sq9nje/step_attenuator/README.md

# Weinschel Step Attenuator Controller

## Links
- [WT32-ETH01](https://github.com/egnor/wt32-eth01)
