sq9nje/step_attenuator/step_attenuator.kicad_pcb

## KiCad design step_attenuator.kicad_pcb (2025-05-12)

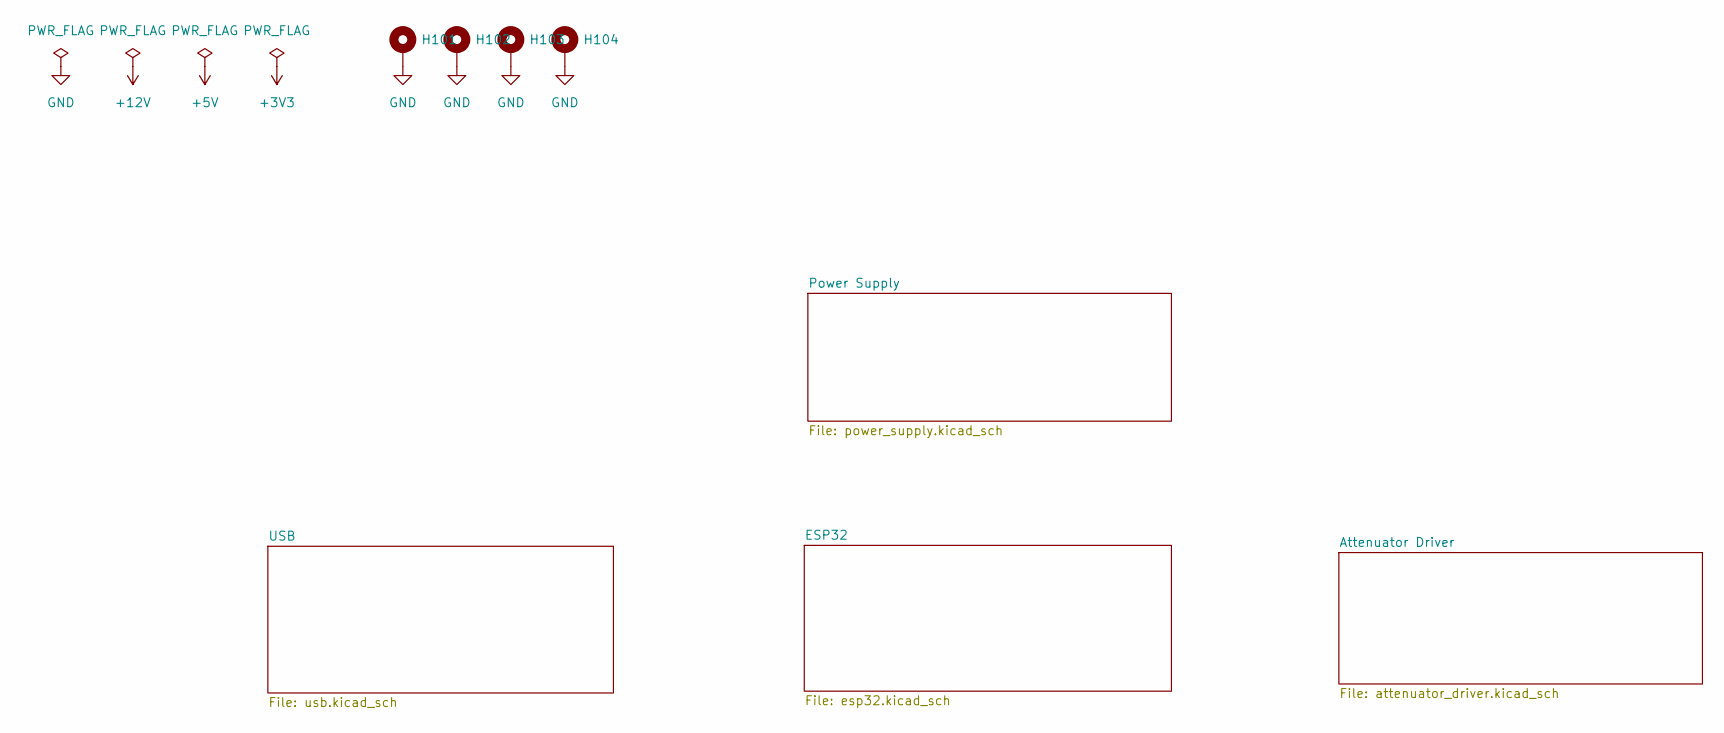
[picture p1: schematic step_attenuator.kicad_sch, Weinschel Step Attenuator Controller]

Parts:
H101, H102, H103, H104: MountingHole_Pad; MountingHole_3.2mm_M3_Pad_Via

Connections:
GND: H101.1, H102.1, H103.1, H104.1; also elsewhere on the board

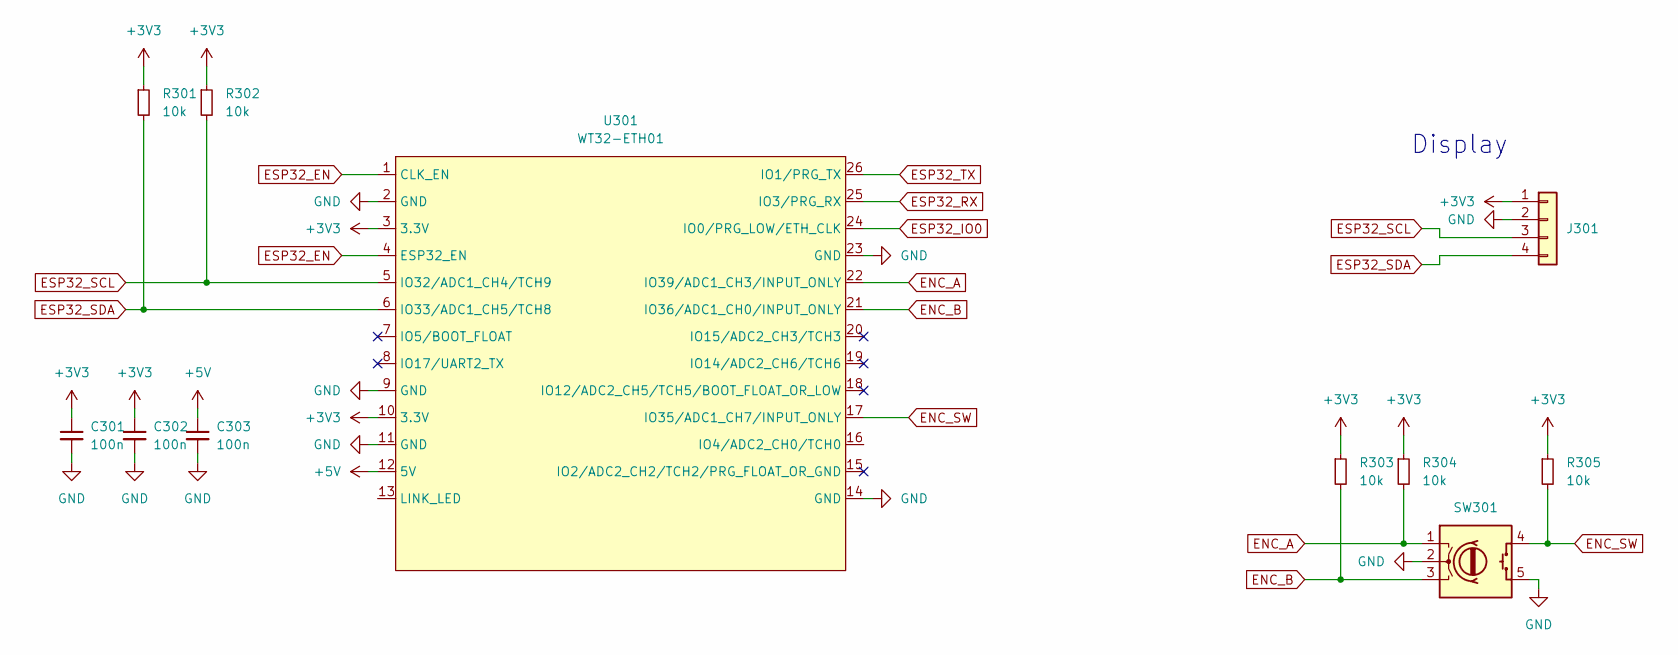
[picture p2: schematic esp32.kicad_sch, Weinschel Step Attenuator Controller]

Parts:
C301, C302, C303: 100n; C_0603_1608Metric_Pad1.08x0.95mm_HandSolder
J301: Conn_01x04; JST_XH_B4B-XH-A_1x04_P2.50mm_Vertical
R301, R302, R303, R304, R305: 10k; R_0603_1608Metric_Pad0.98x0.95mm_HandSolder
SW301: RotaryEncoder_Switch; JST_XH_B5B-XH-A_1x05_P2.50mm_Vertical
U301: WT32-ETH01

Connections:
+3V3: C301.1, C302.1, J301.1, R301.1, R302.1, R303.1, R304.1, R305.1, U301.3 (3.3V), U301.10 (3.3V); also elsewhere on the board
+5V: C303.1, U301.12 (5V); also elsewhere on the board
ENC_A: R304.2, SW301.1 (A), U301.22 (IO39/ADC1_CH3/INPUT_ONLY)
ENC_B: R303.2, SW301.3 (B), U301.21 (IO36/ADC1_CH0/INPUT_ONLY)
ENC_SW: R305.2, SW301.4 (S1), U301.17 (IO35/ADC1_CH7/INPUT_ONLY)
ESP32_EN: U301.1 (CLK_EN), U301.4 (ESP32_EN); also elsewhere on the board
ESP32_IO0: U301.24 (IO0/PRG_LOW/ETH_CLK); also elsewhere on the board
ESP32_RX: U301.25 (IO3/PRG_RX); also elsewhere on the board
ESP32_SCL: J301.3, R302.2, U301.5 (IO32/ADC1_CH4/TCH9); also elsewhere on the board
ESP32_SDA: J301.4, R301.2, U301.6 (IO33/ADC1_CH5/TCH8); also elsewhere on the board
ESP32_TX: U301.26 (IO1/PRG_TX); also elsewhere on the board
GND: C301.2, C302.2, C303.2, J301.2, SW301.2 (C), SW301.5 (S2), U301.2 (GND), U301.9 (GND), U301.11 (GND), U301.14 (GND), U301.23 (GND); also elsewhere on the board

Notes on the sheet:
Display

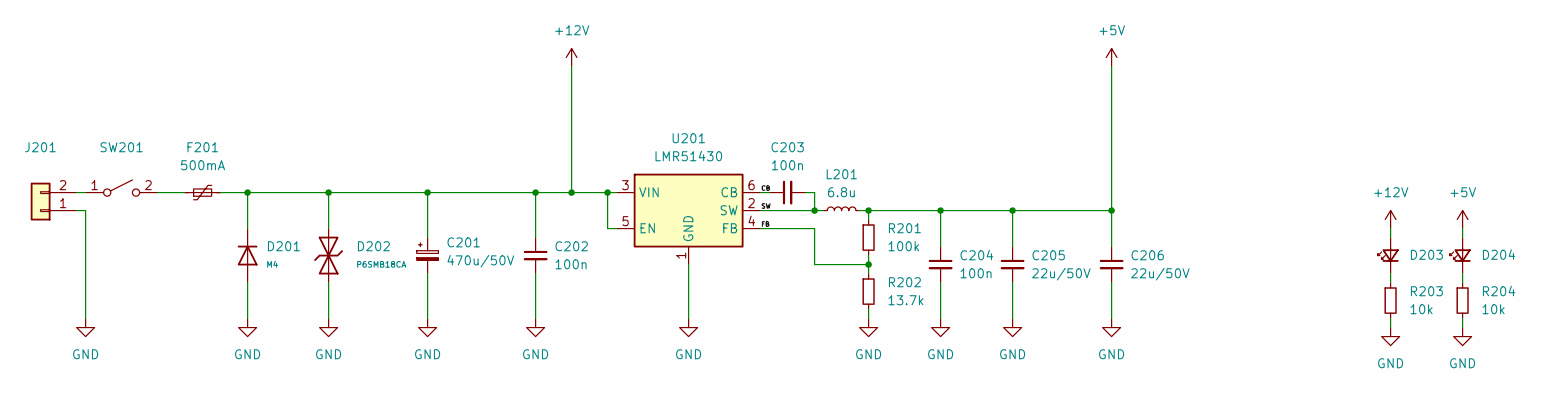
[picture p3: schematic power_supply.kicad_sch, Weinschel Step Attenuator Controller]

Parts:
C201: 470u/50V; CP_Radial_D10.0mm_P5.00mm
C202, C203, C204: 100n; C_0603_1608Metric
C205, C206: 22u/50V; C_1206_3216Metric
D201: M4; D_SMA; Forward Voltage (Vf@If) 1V@1A; Reverse Voltage (Vr) 400V; Part M4; LCSC C18199095
D202: P6SMB18CA; D_SMB; Part P6SMB18CA; LCSC C19077599
D203, D204: LED_Small; D_0805_2012Metric_Pad1.15x1.40mm_HandSolder
F201: 500mA; Fuse_1206_3216Metric_Pad1.42x1.75mm_HandSolder
J201: Conn_01x02; AMASS_XT60PW-M_1x02_P7.20mm_Horizontal
L201: 6.8u; L_10.4x10.4_H4.8
R201: 100k; R_0603_1608Metric
R202: 13.7k; R_0603_1608Metric
R203, R204: 10k; R_0603_1608Metric_Pad0.98x0.95mm_HandSolder
SW201: SW_SPST; Molex_KK-254_AE-6410-02A_1x02_P2.54mm_Vertical
U201: LMR51430; SOT-23-6

Connections:
+5V: C204.1, C205.1, C206.1, D204.2 (A), L201.2, R201.1; also elsewhere on the board
+12V: C201.1, C202.1, D201.1, D202.1, D203.2 (A), F201.2, U201.3 (VIN), U201.5 (EN); also elsewhere on the board
/Power Supply/CB: C203.1, U201.6 (CB)
/Power Supply/FB: R201.2, R202.1, U201.4 (FB)
/Power Supply/SW: C203.2, L201.1, U201.2 (SW)
GND: C201.2, C202.2, C204.2, C205.2, C206.2, D201.2, D202.2, J201.1, R202.2, R203.2, R204.2, U201.1 (GND); also elsewhere on the board
unnamed: D203.1 (K), R203.1
unnamed: D204.1 (K), R204.1
unnamed: J201.2, SW201.1 (A)
unnamed: F201.1, SW201.2 (B)

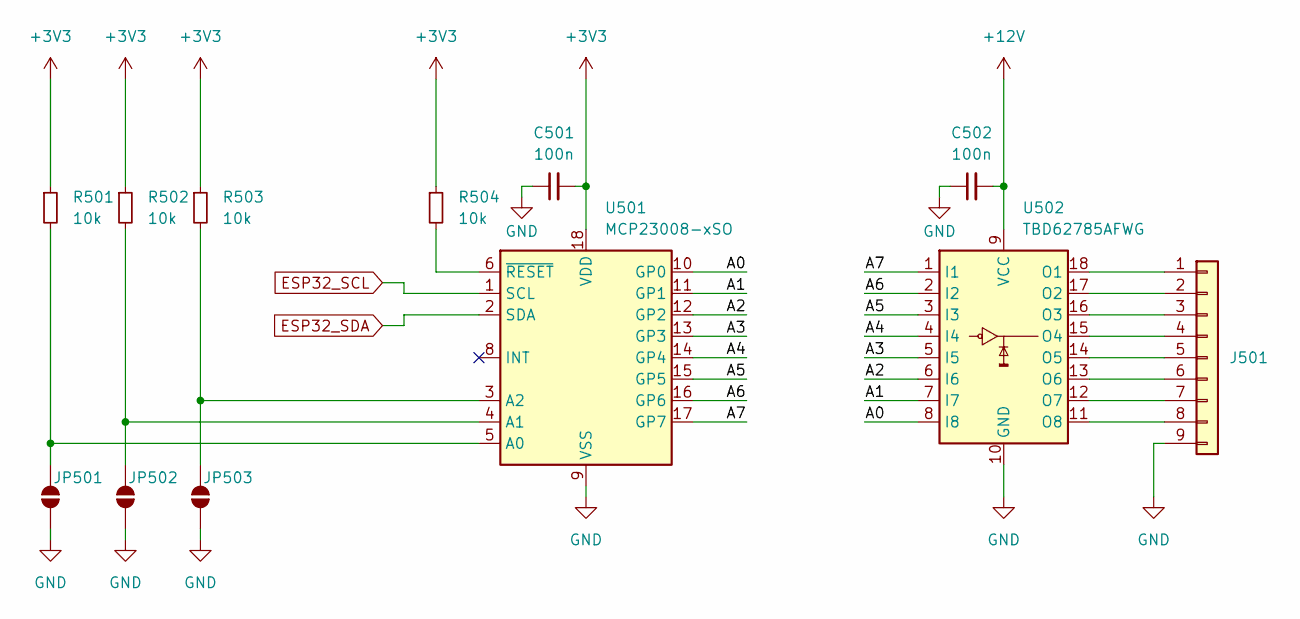
[picture p4: schematic attenuator_driver.kicad_sch, Weinschel Step Attenuator Controller]

Parts:
C501, C502: 100n; C_0603_1608Metric_Pad1.08x0.95mm_HandSolder
J501: Conn_01x09; JST_XH_B9B-XH-A_1x09_P2.50mm_Vertical
JP501, JP502, JP503: SolderJumper_2_Open; SolderJumper-2_P1.3mm_Open_RoundedPad1.0x1.5mm
R501, R502, R503, R504: 10k; R_0603_1608Metric_Pad0.98x0.95mm_HandSolder
U501: MCP23008-xSO; SOIC-18W_7.5x11.6mm_P1.27mm
U502: TBD62785AFWG; SOP-18_7.495x11.515mm_P1.27mm

Connections:
+3V3: C501.2, R501.1, R502.1, R503.1, R504.1, U501.18 (VDD); also elsewhere on the board
+12V: C502.2, U502.9 (VCC); also elsewhere on the board
/Attenuator Driver/A0: U501.10 (GP0), U502.8 (I8)
/Attenuator Driver/A1: U501.11 (GP1), U502.7 (I7)
/Attenuator Driver/A2: U501.12 (GP2), U502.6 (I6)
/Attenuator Driver/A3: U501.13 (GP3), U502.5 (I5)
/Attenuator Driver/A4: U501.14 (GP4), U502.4 (I4)
/Attenuator Driver/A5: U501.15 (GP5), U502.3 (I3)
/Attenuator Driver/A6: U501.16 (GP6), U502.2 (I2)
/Attenuator Driver/A7: U501.17 (GP7), U502.1 (I1)
ESP32_SCL: U501.1 (SCL); also elsewhere on the board
ESP32_SDA: U501.2 (SDA); also elsewhere on the board
GND: C501.1, C502.1, J501.9, JP501.1 (A), JP502.1 (A), JP503.1 (A), U501.9 (VSS), U502.10 (GND); also elsewhere on the board
unnamed: J501.1, U502.18 (O1)
unnamed: J501.2, U502.17 (O2)
unnamed: J501.3, U502.16 (O3)
unnamed: J501.4, U502.15 (O4)
unnamed: J501.5, U502.14 (O5)
unnamed: J501.6, U502.13 (O6)
unnamed: J501.7, U502.12 (O7)
unnamed: J501.8, U502.11 (O8)
unnamed: JP501.2 (B), R501.2, U501.5 (A0)
unnamed: JP502.2 (B), R502.2, U501.4 (A1)
unnamed: JP503.2 (B), R503.2, U501.3 (A2)
unnamed: R504.2, U501.6 (~RESET)

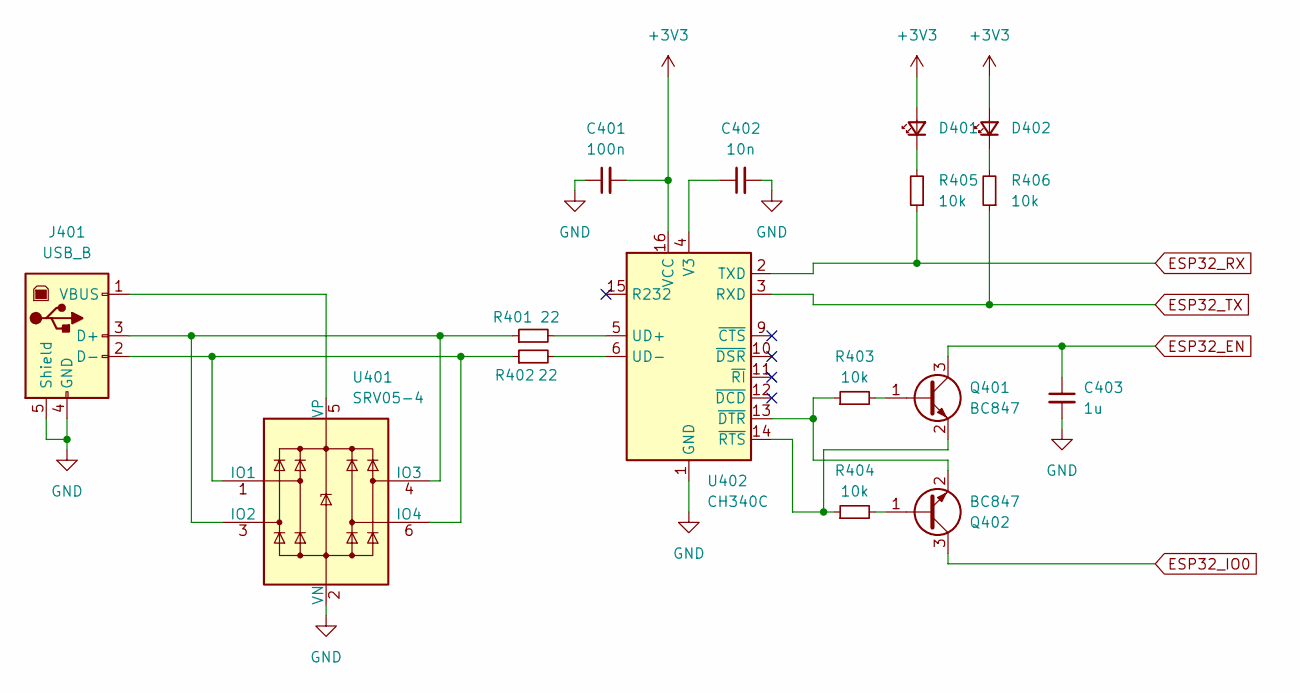
[picture p5: schematic usb.kicad_sch, Weinschel Step Attenuator Controller]

Parts:
C401: 100n; C_0603_1608Metric_Pad1.08x0.95mm_HandSolder
C402: 10n; C_0603_1608Metric_Pad1.08x0.95mm_HandSolder
C403: 1u; C_0603_1608Metric_Pad1.08x0.95mm_HandSolder
D401, D402: LED_Small; D_0805_2012Metric_Pad1.15x1.40mm_HandSolder
J401: USB_B; USB_B_Lumberg_2411_02_Horizontal
Q401, Q402: BC847; SOT-23
R401, R402: 22; R_0603_1608Metric_Pad0.98x0.95mm_HandSolder
R403, R404, R405, R406: 10k; R_0603_1608Metric_Pad0.98x0.95mm_HandSolder
U401: SRV05-4; SOT-23-6
U402: CH340C; SOIC-16_3.9x9.9mm_P1.27mm

Connections:
+3V3: C401.2, D401.2 (A), D402.2 (A), U402.16 (VCC); also elsewhere on the board
ESP32_EN: C403.1, Q401.3 (C); also elsewhere on the board
ESP32_IO0: Q402.3 (C); also elsewhere on the board
ESP32_RX: R405.1, U402.2 (TXD); also elsewhere on the board
ESP32_TX: R406.1, U402.3 (RXD); also elsewhere on the board
GND: C401.1, C402.2, C403.2, J401.4 (GND), J401.5 (Shield), U401.2 (VN), U402.1 (GND); also elsewhere on the board
unnamed: D401.1 (K), R405.2
unnamed: D402.1 (K), R406.2
unnamed: J401.3 (D+), R401.1, U401.3 (IO2), U401.4 (IO3)
unnamed: J401.2 (D-), R402.1, U401.1 (IO1), U401.6 (IO4)
unnamed: J401.1 (VBUS), U401.5 (VP)
unnamed: Q401.1 (B), R403.2
unnamed: Q401.2 (E), R404.1, U402.14 (~RTS)
unnamed: Q402.1 (B), R404.2
unnamed: Q402.2 (E), R403.1, U402.13 (~DTR)
unnamed: R401.2, U402.5 (UD+)
unnamed: R402.2, U402.6 (UD-)
unnamed: C402.1, U402.4 (V3)

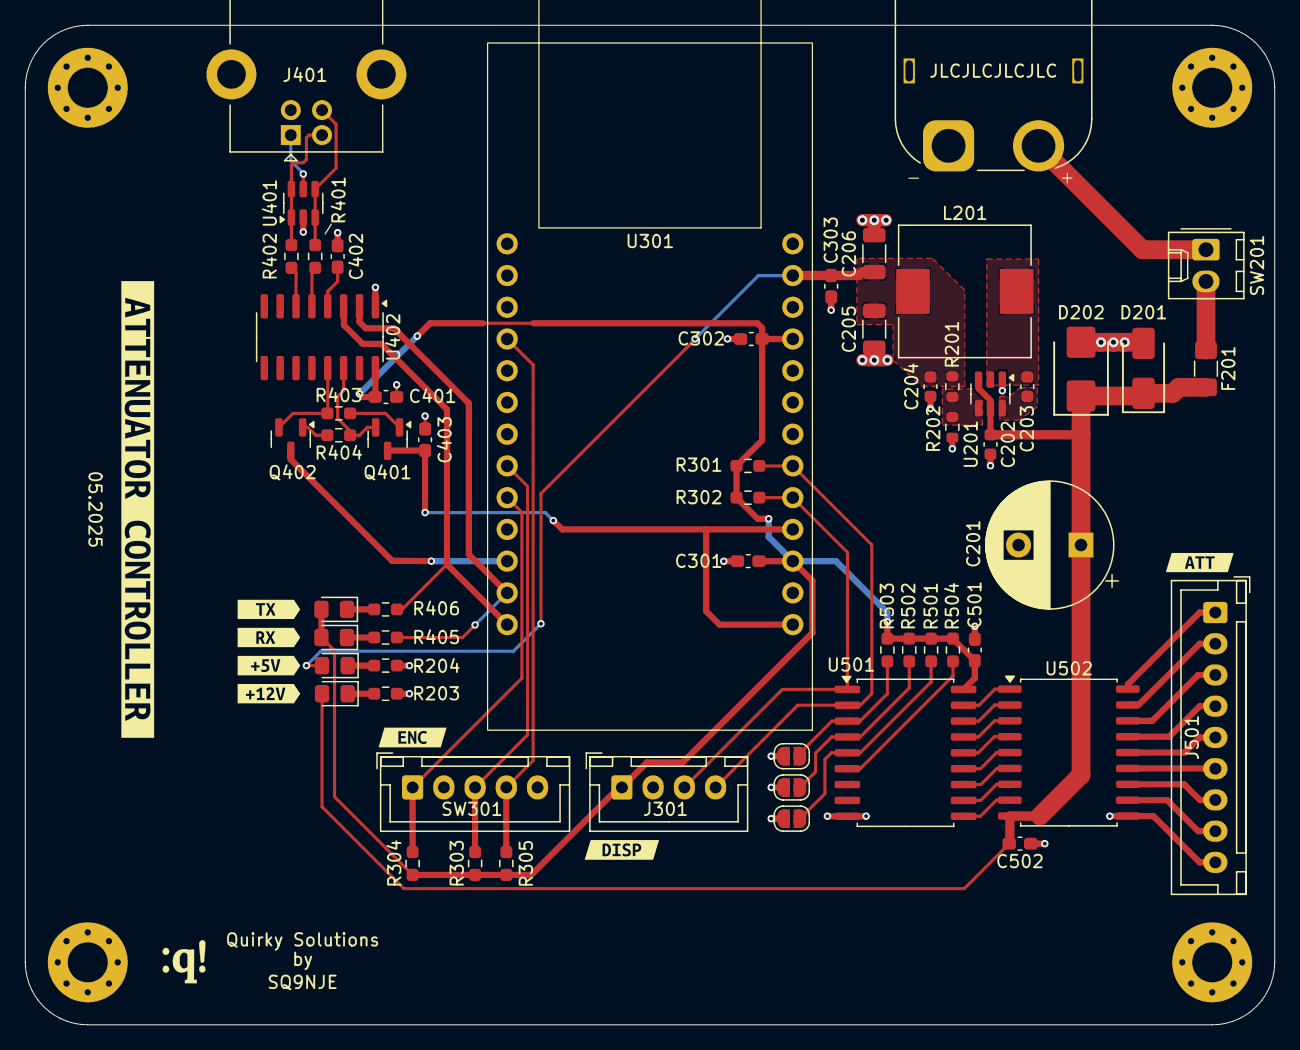
[picture p6: board step_attenuator.kicad_pcb from above]

Board: 2 copper layers, 100.0 x 80.0 mm, 71 parts (0 on the bottom side), 52 nets.

Other parts of the board:
Ref**: Val**; qs_logo
kibuzzard-68053CB6: G***; kibuzzard-68053CB6
kibuzzard-68053CC3: G***; kibuzzard-68053CC3
kibuzzard-68053CCC: G***; kibuzzard-68053CCC
kibuzzard-68053CD4: G***; kibuzzard-68053CD4
kibuzzard-68053E7E: G***; kibuzzard-68053E7E
kibuzzard-68053E53: G***; kibuzzard-68053E53
kibuzzard-68053EA0: G***; kibuzzard-68053EA0
kibuzzard-68054915: G***; kibuzzard-68054915
